CosmicMac/ESP32-VR-Pinball-Controller/assets/mpu6050.jpg

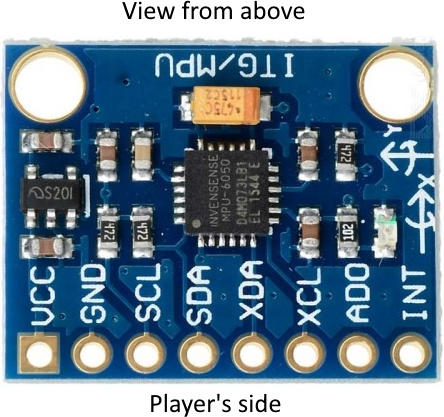
assets/mpu6050.jpg
