CosmicMac/ESP32-VR-Pinball-Controller/(commit log)

2026-03-01 Fix nudge forward left stick input for CLASSIC mode
    [ESP32_VR_Pinball_Controller.ino]
2026-03-01 Added mention to dedicated button for mode cycling
2026-06-27 Remove unused INT pin reference from README
